diogosec/SmartHive/README.md

# Monitoramento de Colmeias com ESP32 e Arduino IoT Cloud

## Descrição
Este projeto visa monitorar o peso e a temperatura de colmeias em tempo real, utilizando um microcontrolador ESP32 C3 e a plataforma Arduino IoT Cloud. Os dados coletados são transmitidos via Wi-Fi e visualizados em um dashboard, permitindo que apicultores acompanhem o estado das colmeias de forma eficiente. O sistema também emite alertas para eventos importantes, como variações no peso que podem indicar a necessidade de colheita ou atividade anormal.

## Objetivo
Aumentar a produtividade e fornecer um manejo mais assertivo para apicultores, com a possibilidade de adaptar o protótipo para diferentes áreas, como industrial, comercial ou residencial.

## Instalação

1. Abra o arquivo `sketch123.ino` na Arduino IDE.
2. Modifique as configurações de rede Wi-Fi no código.
3. Carregue o código na placa ESP32 C3.

## Funcionamento
O sistema coleta dados de peso e temperatura da colmeia, transmitindo-os para a Arduino IoT Cloud. O apicultor pode monitorar essas informações via dashboard, recebendo alertas sobre condições críticas, como aumento de peso para colheita ou perda rápida de peso.
