diogosec/SmartHive/Documentation/Smart Hive - Electrical Diagram.pdf

# Esquema elétrico

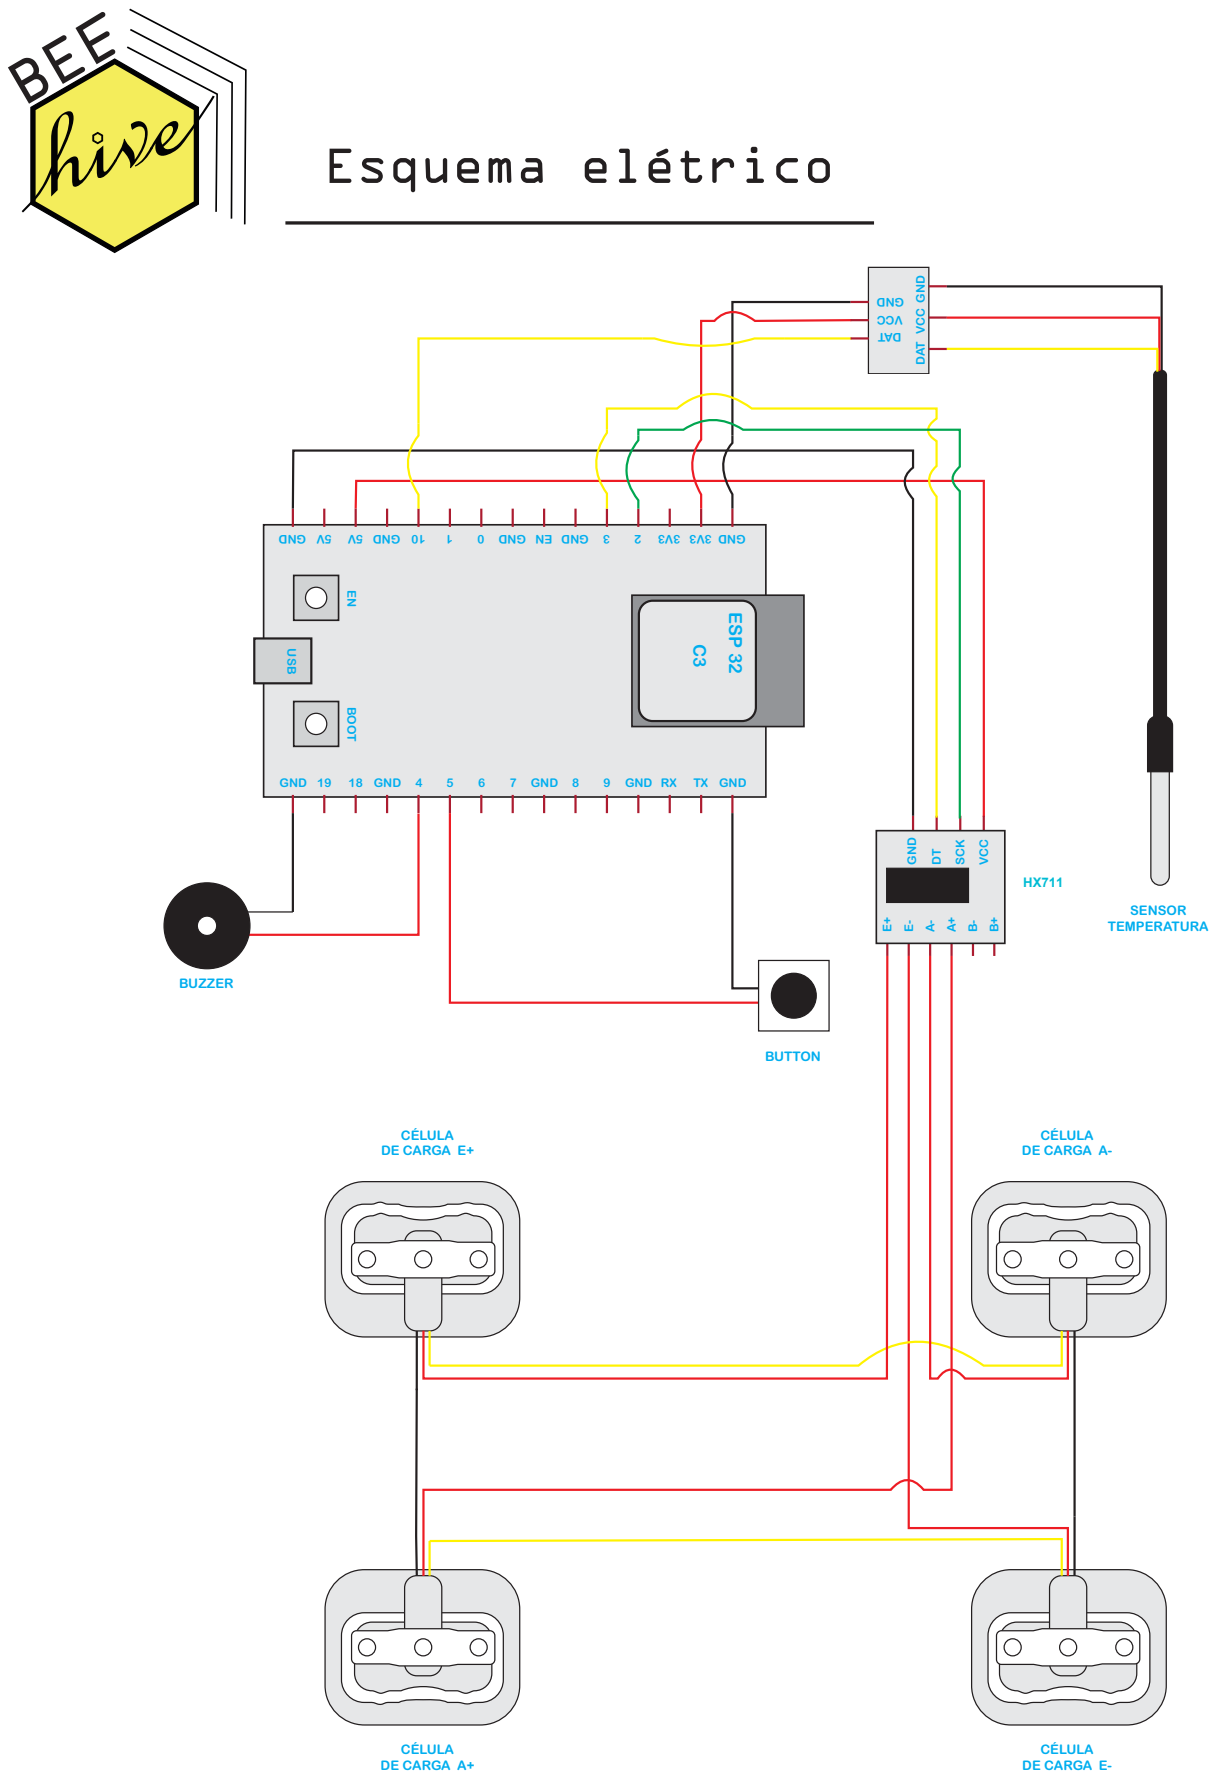
[picture p6: page 1]
USB; GND 19; 18 GND; GND; GND RX; TX GND EN BOOT; ESP 32; BUZZER; BUTTON; SCK; VCC; SENSOR TEMPERATURA; CÉLULA DE CARGA E+; CÉLULA DE CARGA A+; CÉLULA DE CARGA A-; CÉLULA DE CARGA E-; GND DAT
