diogosec/SmartHive/Measurement History/27.09.24/SmartHive-Peso.csv

time | value
2024-09-27T12:00:32.760095516Z | 0
2024-09-27T12:00:42.775737547Z | 0
2024-09-27T12:00:52.759511649Z | 0
2024-09-27T12:01:04.043530752Z | 0
2024-09-27T12:01:15.320436347Z | 1.8842723369598389
2024-09-27T12:01:26.590905478Z | 1.9194189310073853
2024-09-27T12:01:37.850349124Z | 1.8937370777130127
2024-09-27T12:01:49.139922967Z | 1.903680682182312
2024-09-27T12:02:00.409909871Z | 1.9051085710525513
2024-09-27T12:02:11.680428684Z | 1.9097298383712769
2024-09-27T12:02:22.950576357Z | 1.911649227142334
2024-09-27T12:02:35.367841984Z | 1.9206180572509766
2024-09-27T12:02:45.502066321Z | 1.9285781383514404
2024-09-27T12:02:56.773237667Z | 1.187425136566162
2024-09-27T12:03:07.919563103Z | 1.1972426176071167
2024-09-27T12:03:20.895325019Z | 2.044250011444092
2024-09-27T12:03:30.633170601Z | 2.0863757133483887
2024-09-27T12:03:40.50220421Z | 2.0930466651916504
2024-09-27T12:03:51.135491861Z | 2.197270393371582
2024-09-27T12:04:02.877020004Z | 2.2248737812042236
2024-09-27T12:04:11.222718149Z | 2.224121332168579
2024-09-27T12:04:21.11294021Z | 2.226374387741089
2024-09-27T12:04:32.893100778Z | 2.2278149127960205
2024-09-27T12:04:43.3671077Z | 2.2313268184661865
2024-09-27T12:04:53.59618353Z | 2.233246326446533
2024-09-27T12:05:04.877801989Z | 2.232964277267456
2024-09-27T12:05:16.14777707Z | 2.233703851699829
2024-09-27T12:05:27.412540794Z | 2.236354351043701
2024-09-27T12:05:38.692478058Z | 2.237386703491211
2024-09-27T12:05:49.951087459Z | 2.2396674156188965
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
2024-09-27T13:07:25.367833107Z | 1.7327975034713745
2024-09-27T13:07:36.617137501Z | 1.7294907569885254
2024-09-27T13:07:47.84762318Z | 1.7282896041870117
2024-09-27T13:07:59.12899013Z | 1.7263209819793701
2024-09-27T13:08:10.385554392Z | 1.723136067390442
