diogosec/SmartHive/Measurement History/27.09.24/SmartHive-temperature.csv

time | value
2024-09-27T12:00:32.760095516Z | 0
2024-09-27T12:00:42.775737547Z | 0
2024-09-27T12:00:52.759511649Z | 0
2024-09-27T12:01:04.043530752Z | 0
2024-09-27T12:01:15.320436347Z | 23.875
2024-09-27T12:01:26.590905478Z | 23.625
2024-09-27T12:01:37.850349124Z | 23.5
2024-09-27T12:01:49.139922967Z | 23.375
2024-09-27T12:02:00.409909871Z | 23.5625
2024-09-27T12:02:11.680428684Z | 27.1875
2024-09-27T12:02:22.950576357Z | 28.625
2024-09-27T12:02:35.367841984Z | 29.3125
2024-09-27T12:02:45.502066321Z | 28.8125
2024-09-27T12:02:56.773237667Z | 27.6875
2024-09-27T12:03:07.919563103Z | 27.0625
2024-09-27T12:03:20.895325019Z | 26.6875
2024-09-27T12:03:30.633170601Z | 26.3125
2024-09-27T12:03:40.50220421Z | 26.125
2024-09-27T12:03:51.135491861Z | 25.6875
2024-09-27T12:04:02.877020004Z | 25.4375
2024-09-27T12:04:11.222718149Z | 25.125
2024-09-27T12:04:21.11294021Z | 24.9375
2024-09-27T12:04:32.893100778Z | 24.6875
2024-09-27T12:04:43.3671077Z | 24.4375
2024-09-27T12:04:53.59618353Z | 24.25
2024-09-27T12:05:04.877801989Z | 24
2024-09-27T12:05:16.14777707Z | 23.8125
2024-09-27T12:05:27.412540794Z | 23.625
2024-09-27T12:05:38.692478058Z | 23.5
2024-09-27T12:05:49.951087459Z | 23.3125
2024-09-27T12:06:01.223772799Z | 23.1875
2024-09-27T12:06:35.494172105Z | 22.6875
2024-09-27T12:06:45.676235617Z | 22.5625
2024-09-27T12:06:56.94649704Z | 22.4375
2024-09-27T12:07:08.606311273Z | 22.375
2024-09-27T12:07:19.504679251Z | 22.3125
2024-09-27T12:07:36.636436351Z | 22.25
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
2024-09-27T13:07:02.863769214Z | 23.8125
2024-09-27T13:07:14.119907386Z | 23.75
2024-09-27T13:07:25.367833107Z | 23.6875
2024-09-27T13:07:36.617137501Z | 23.625
2024-09-27T13:07:47.84762318Z | 23.5625
2024-09-27T13:07:59.12899013Z | 23.5625
2024-09-27T13:08:10.385554392Z | 23.5625
